bhanuGupta1/esp32-espnow-thingsboard-gateway/evidence/video_02_thingsboard_walkthrough.gif

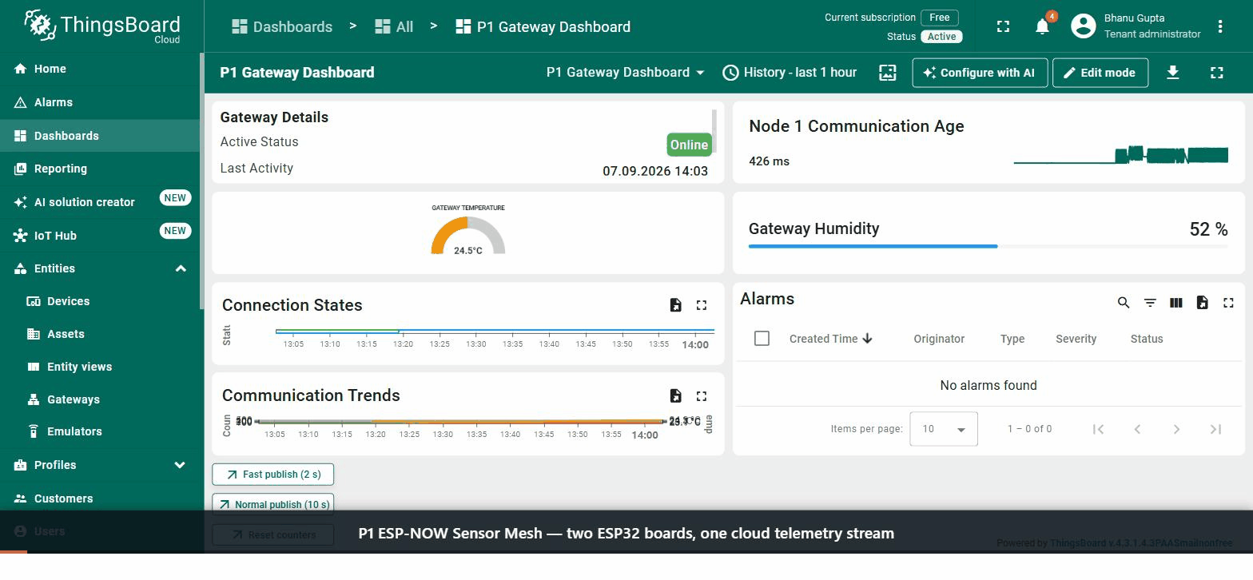
evidence/video_02_thingsboard_walkthrough.gif
