bhanuGupta1/esp32-espnow-thingsboard-gateway/evidence/07_build_sizes.txt

P1 build size evidence
Generated by .claude/verify.local.sh equivalent; arduino-cli arduino-cli  Version: 1.3.1 Commit: 08ff7e2b Date: 2025-08-28T13:51:38Z
Core: esp32:esp32   3.3.3            3.3.8            esp32
FQBN: esp32:esp32:esp32 (ESP32 Dev Module, default partition scheme)

Name                    Installed Available Location Description
Adafruit Unified Sensor 1.1.15    -         user     -
DHT sensor library      1.4.7     -         user     -
FastGPIO                2.2.0     -         user     -
PololuBuzzer            1.2.0     -         user     -
PololuHD44780           2.0.0     -         user     -
PololuOLED              2.0.0     -         user     -
PubSubClient            2.8       -         user     -
Pushbutton              2.0.0     -         user     -
USBPause                2.0.0     -         user     -
Zumo32U4                2.0.1     -         user     -
ZumoAutomation          1.0.3     -         user     -
ZumoShield              2.1.0     -         user     -

=== 01_board1_dht_test ===

Sketch uses 284039 bytes (21%) of program storage space. Maximum is 1310720 bytes.
Global variables use 20816 bytes (6%) of dynamic memory, leaving 306864 bytes for local variables. Maximum is 327680 
bytes.

=== 02_board2_dht_test ===

Sketch uses 284071 bytes (21%) of program storage space. Maximum is 1310720 bytes.
Global variables use 20816 bytes (6%) of dynamic memory, leaving 306864 bytes for local variables. Maximum is 327680 
bytes.

=== 03_board2_gateway_info ===

Sketch uses 885539 bytes (67%) of program storage space. Maximum is 1310720 bytes.
Global variables use 43384 bytes (13%) of dynamic memory, leaving 284296 bytes for local variables. Maximum is 327680 
bytes.

=== 04_board1_espnow_sender ===

Sketch uses 898803 bytes (68%) of program storage space. Maximum is 1310720 bytes.
Global variables use 43504 bytes (13%) of dynamic memory, leaving 284176 bytes for local variables. Maximum is 327680 
bytes.

=== 05_board2_gateway_cloud ===

Sketch uses 1012651 bytes (77%) of program storage space. Maximum is 1310720 bytes.
Global variables use 45624 bytes (13%) of dynamic memory, leaving 282056 bytes for local variables. Maximum is 327680 
bytes.
