bhanuGupta1/esp32-espnow-thingsboard-gateway/(commit log)

2026-08-13 Add ESP-NOW sensor gateway firmware, report and test evidence
    Two-node ESP32 prototype: a remote node reads a DHT11 and unicasts
    readings over ESP-NOW; a gateway node reads its own sensor, receives
    and deduplicates the remote packets, and publishes the merged payload
    to ThingsBoard over MQTT.
    Five staged Arduino sketches, captured serial logs and photographs
    covering all eleven acceptance criteria, and the project report.
    Wi-Fi and cloud credentials are excluded via .gitignore; see
    secrets.example.h for the required constants.
2026-08-13 Embed figures in report, add docx build and demo runsheet
    Figures 1-3 (hardware photographs) and 4-7 (dashboard screenshots) are now
    displayed inline with captions rather than referenced by filename, so the
    portfolio reads as evidence rather than a file listing.
    DEMO_PLAN.md covers the assessed 10-minute demonstration and 5-minute
    question period: a timed running order, the sensor-warming gesture that
    exercises the full sensor-to-cloud path in about fifteen seconds, and
    prepared answers for the design decisions the build invites.
2026-08-13 Verify ESP-NOW sender identity and correct report accuracy claims
    Independent review surfaced that the gateway validated the src_id field
    inside each packet but never checked who actually sent the frame. Because
    it accepts unregistered, unencrypted peers, any nearby ESP-NOW device could
    submit a well-formed packet; one carrying a high sequence number under the
    live boot_id would advance the deduplication baseline and cause every
    genuine packet to be rejected until the node rebooted. The receive callback
    now discards frames whose source MAC is not the configured node address.
    Cross-task counters move to std::atomic. The queue-overflow counter was
    incremented on the Wi-Fi task while loop() re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
    [04_board1_espnow_sender.ino, 05_board2_gateway_cloud.ino]
2026-08-13 Add presentation deck, submission checklist and course documents
    Sixteen-slide deck sized to the assessed ten-minute slot, with speaker
    notes carrying timing and the points worth saying aloud rather than
    putting on a slide.
    Submission checklist records what the two briefs actually require against
    what exists. Part 1 is an individual case study analysis worth 40% and is
    not addressed here; Part 2 is this project. Noting the distinction because
    the Part 2 marking scheme rewards alignment with the case study.
    Also closes the remaining review findings: both sketches now halt rather
    than continue when ESP-NOW setup fails, since carrying on would announce
    that the gateway is listening while it i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
    [04_board1_espnow_sender.ino, 05_board2_gateway_cloud.ino]
2026-08-13 Add Part 1 case study analysis with original diagrams
    Draft of the individual case study assessment covering Project 1, the
    same ESP-NOW sensor network built for Part 2. Six sections to the brief's
    word budgets, seventeen references, and three diagrams drawn from the
    system as implemented rather than from a generic reference architecture:
    system architecture, data flow showing where frames are discarded, and a
    security model marking trust boundaries against residual exposure.
    Passages requiring the author's own experience are left marked rather
    than filled, since the brief asks for prior hands-on work, what the
    author found difficult, and insights from their own background. The
    reference li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
2026-08-13 Encrypt and authenticate the ESP-NOW link
    A second adversarial review rejected source MAC filtering as a trust
    boundary. The objection was correct: 802.11 source addresses are forgeable
    by anyone already able to inject frames, so an attacker could still observe
    the live boot_id, transmit as the node, and advance the deduplication
    baseline until the real sensor was silenced. Filtering on a value the
    attacker controls is not authentication.
    Both boards now install a primary master key and register each other as
    encrypted peers carrying a local master key. A frame is accepted because it
    decrypts under a key the sender must hold rather than because of an address
    the sender chose. The gateway ne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
    [04_board1_espnow_sender.ino, 05_board2_gateway_cloud.ino, secrets.example.h]
2026-08-13 Verify encrypted ESP-NOW on hardware and record a channel roam
    Encryption now runs behind a compile-time flag that must match on both
    boards, and has been confirmed working with the gateway associated to an
    access point while the node is not: 42 packets received with no invalid
    frames and no rejected senders.
    The first hardware test after enabling encryption delivered nothing, which
    looked like encryption failing between an associated and an unassociated
    station. It was not. The gateway had roamed from channel 1 to channel 11
    during the session while the node stayed pinned to the old channel, so no
    frame could have arrived whatever the security settings. Correcting the
    channel restored deli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
    [04_board1_espnow_sender.ino, 05_board2_gateway_cloud.ino]
2026-08-13 Draft case study authenticity sections from the project record
    Sections 8.1 to 8.3 are written from what actually happened: the prior
    solar-powered car project, the three findings that were genuinely new, and
    the misdiagnosis where a channel roam was mistaken for encryption failing.
    All of it is drawn from the session record rather than invented, and is
    marked for the author to correct against their own recollection.
    Sections 8.4 and 8.5 are deliberately left unwritten. They ask for industry
    exposure and personal background, which cannot be reconstructed from what
    the project produced. Both carry scaffolding and candidate angles instead.
    Four references were checked against published recor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
2026-08-13 Add AI use declaration and fill author details
    Declaration drafted to be accurate rather than minimal: it names the
    firmware, both written documents, the two independent code reviews and the
    debugging assistance as AI-assisted, and separates out the physical work,
    the empirical evidence and the project decisions that were not.
    An understated disclosure is a worse position than a complete one, since a
    marker forming a different impression from the work itself would then be
    judging the declaration rather than the assistance.
    Also corrects the case study executive summary, which still described the
    radio link as unencrypted and unauthenticated after that had been fixed and
    verified on hardwar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
2026-08-13 Complete author details across submission documents
    Student name, identifier and cohort filled on both official cover sheets
    and on the title pages of the case study and the AI declaration. Signature
    and date fields are left blank on the cover sheets, since those are signed
    by hand against a declaration of original work.
2026-08-14 Complete case study for submission
    Sections 8.4 and 8.5 written. The industry-parallels section compares the
    design against a documented LoRa agricultural deployment rather than
    claiming direct experience there is none, which is the honest position and
    draws a more useful comparison: same economics of many unconnected sensors
    behind one gateway, but range and inaccessibility make the single-gateway
    risk far more serious in the field than on a bench.
    Sections trimmed to the word budgets set by the brief. The technical
    architecture section was 46 per cent over and is now within range, mostly
    by removing restatement between the executive summary, the security
    subsection and the risk analysis.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
2026-09-03 Add server-to-device RPC and store-and-forward buffering
    The MQTT link was telemetry-only, which makes the device observable but not
    manageable: an operator could see what it reported but could not change how
    it behaved without physical access. The gateway now subscribes to the
    ThingsBoard RPC request topic and implements getStatus, setPublishInterval
    and resetCounters, replying on the matching response topic.
    setPublishInterval range-checks and rejects rather than clamping. Silently
    applying a value the caller did not ask for would leave them believing
    something untrue about the device. The subscription is re-issued on every
    reconnect, since MQTT subscriptions are session state - a device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
    [05_board2_gateway_cloud.ino]
2026-09-03 Keep the document converter with the project
    The Markdown to Word converter was living in a temporary directory and was
    lost when that was cleared, so the documents could not be regenerated from
    source. It now sits in tools/ alongside the material it builds.
2026-09-03 Fix buffer slots being smaller than the payload they hold
    Hardware testing showed the store-and-forward buffer storing nothing. The log
    claimed a payload had been buffered while reporting a queue depth of zero on
    every publish, and buffered_now never moved off zero.
    Slots were 288 bytes, sized against a payload that predated the five RPC and
    buffering telemetry keys. Once those were added the payload reached 326 bytes,
    so every write hit the size guard and returned. The guard returned quietly, and
    the log line printed the queue depth from before the call rather than after, so
    nothing in the output indicated a problem.
    Slot size and payload size now derive from one constant. The size guard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
    [04_board1_espnow_sender.ino, 05_board2_gateway_cloud.ino]
2026-09-06 Add pin-level circuit diagram
    The report carried an architecture block diagram and photographs, but nothing
    that showed which pin connects to which. A reader could not reproduce the build
    from the document alone.
    The generator draws both boards in the wire colours actually used on the bench,
    marks the only wiring difference between them (GPIO4 against GPIO5), and shows
    the ESP-NOW link as the sole path between two otherwise isolated circuits.
2026-09-06 Pin node to channel 1 to match the roamed gateway
    The gateway had settled on channel 1 while the node was still pinned to 6, so
    every transmission went unacknowledged and node telemetry stopped reaching the
    cloud. Wi-Fi and MQTT stayed healthy throughout, which is what makes this
    failure hard to spot.
    Read off the gateway boot banner before a demonstration; the value is a property
    of the access point, not a setting the project controls.
    [04_board1_espnow_sender.ino]
2026-09-06 Record verified bidirectional control and buffer flush
    Both capabilities were implemented but had never been observed working end to
    end: no command had been sent from the dashboard, and the buffer had only ever
    been seen filling, never draining.
    Three RPC command buttons now exist on the dashboard. Pressing them produced the
    request and the applied change in the gateway log, and the new interval and
    handled count came back in the next telemetry publish, so the round trip is
    confirmed from both ends rather than from a dashboard acknowledgement. The same
    capture showed four payloads buffered during an outage and all four flushed with
    none dropped.
    Adds acceptance criteria 12 and 13, section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
2026-09-06 Align case study security claims with the implemented design
    The case study documented ESP-NOW encryption as implemented in its security
    section, then contradicted itself in three places: the specification table
    listed the local protocol as unencrypted, the OWASP assessment claimed missing
    transport encryption on both legs, and the first security recommendation was to
    enable the encryption the system already has.
    Transport encryption is now scoped to the cloud leg, which is where it is
    genuinely absent, and the recommendations start with MQTT over TLS. The
    description of the original design at the top of section 2.4 stays in the past
    tense, since the point it makes about identifiers and aut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
2026-09-06 Bridge the portfolio to the case study and the video evidence
    The heaviest-weighted marking criterion asks that the implementation align with
    the case study, but the portfolio never referred to it. A reader had no way to
    check the two against each other without reading both end to end and building
    the mapping themselves.
    Section 1.1 now states the correspondence point by point, and names the two
    places the work diverged: the sensor substitution, and the RPC and buffering
    capabilities that were added after the analysis was written and that it
    therefore does not describe.
    The brief also asks for demo videos on OneDrive with the links carried in the
    portfolio. There was nowhere to put them, s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
2026-09-06 Rework the video shot list around what the system can now do
    The shot list predated bidirectional control, so it captured only the upward
    path. Pressing a dashboard button and watching the device change behaviour is
    the strongest single thing this project can show, and it was missing.
    Adds that shot, a note on demonstrating the buffer by pulling the network
    rather than the board, and a pre-flight check for the roamed channel.
    Also specifies -NoReset on the serial monitor. Attaching without it reboots the
    board, which reprints the boot banner and puts the eduroam identity on screen
    in a recording intended for upload.
2026-09-07 Name both authors and state the contribution split
    The portfolio is a group submission but carried one author and a placeholder,
    so nothing in it recorded who the second author was or how the work divided.
    Section 11.1 was already written in the first person plural, so it stands as a
    joint reflection and needs no second version.
2026-09-07 Draft the generative AI disclosure
    The section held example placeholders rather than a statement, so there was
    nothing to submit against a requirement the brief makes explicitly.
    The draft records AI involvement as substantial, because it was, and sets
    against it the work the authors did themselves: all hardware assembly, wiring
    and physical testing, all evidence capture, and the operation of the boards
    during every test that produced a result in this portfolio.
    Wording still needs checking against the course's own Responsible Use of AI
    guidelines before it is signed.
2026-09-07 Capture both boards on one clock
    Every previous log reads a single serial port, so the node's "link-layer ack
    received" and the gateway's "ESP-NOW rx" were two separate observations that
    had to be trusted to describe the same packet. Polling both ports from one
    process closes that gap: the same sequence number appears at both ends one
    millisecond apart, which also measures the radio round trip.
    The link was down when the capture started. The gateway had settled on channel
    6 while the node was still pinned to 1 from earlier today, so the first attempt
    recorded the failure rather than the success - the node reporting no ack while
    the gateway published its own readings and declared the node of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
    [04_board1_espnow_sender.ino]
2026-09-07 Record the cloud half of the demo and fix the mesh dashboard
    The second dashboard held both line charts in a narrow column, so the plots sat
    below the fold and it rendered as two empty boxes. Both are now full width and
    stacked, and the traces they were built to compare are visible: the gateway's
    own sensor against the remote node arriving by radio.
    Adds a screen recording of the dashboard responding to a command - live
    telemetry, the button press, and the device reporting the new interval and
    handled count back in its own telemetry. It covers the cloud portion of the
    demonstration only; the hardware shots still have to be filmed.
2026-09-07 Add a captioned walkthrough of the cloud tier
    The earlier capture showed the RPC round trip and nothing else, which left the
    dashboards themselves undocumented in motion.
    This one runs the whole cloud story with subtitles burned into the frames: the
    gateway online, node communication age counting in milliseconds, the command
    going down and the device reporting the new interval back, the node keys that
    originate on a board with no network connection, and both sensors drawn on one
    chart.
    It still covers the cloud tier only. The boards do not appear in it, so the
    demonstration video is not replaced by it, and the report says so rather than
    letting a reader assume otherwise.
2026-09-07 Assemble the demonstration video and script its narration
    The phone footage of the boards and the two screen captures existed as three
    separate files a marker would have to open in turn and mentally stitch
    together. They are now one 1280x720 cut with title and section cards, subtitles
    burned into the frames, and the portrait phone clip seated on a blurred fill
    rather than pillarboxed.
    Two seconds of the walkthrough show a page mid-load. That is what navigating
    actually looked like, so it stays.
    The narration is scripted against the assembled timings with word counts per
    segment, and the script says plainly which three shots are still missing: the
    sensor warmed by hand, and Board 1 disconne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
2026-09-07 Cut the bench footage into the demonstration video
    Two clips filmed at the bench are now in the timeline: the dashboard running
    beside the hardware, and Board 1 having its power pulled. The video runs 1:49.
    The caption on the disconnection says what the frame shows and no more. The
    consequence - node1_online going false after twenty seconds - is not in the
    footage, so it is attributed to section 8.5 rather than implied. The narration
    script carries the same warning against claiming it on camera.
    That missing shot is now the first item on the list of what still needs
    filming, because without it the sequence pulls a cable and asks the viewer to
    take the result on trust.
2026-09-07 Remove the last placeholders and correct two false claims
    The video is 7 MB, under Moodle's 40 MB limit, so it is submitted with the
    portfolio rather than hosted. The two "paste OneDrive share link" placeholders
    are gone along with the need for them.
    The AI declaration carried two statements that were not true. It said the case
    study has seventeen references when it has eighteen, and that the unchecked
    ones are marked in that document as requiring verification, which they are not.
    Both are corrected, because a declaration that misdescribes the work is worse
    than the disclosure it was meant to make.
    It also named one author while Part 2 is a joint submission, so Roshan Aryal is
    named with t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
2026-09-07 Add narration to the demonstration video and declare it
    The narration runs 130 s against a 109 s cut. The extra 21 s is absorbed by the
    static cards rather than by stretching footage, because stretching would drift
    the burned-in captions away from what is on screen. A pause in the narration
    falls within a second of the recap-card boundary, which suggests the blocks are
    tracking, but the synchronisation has not been checked by ear.
    The voice is synthesised, not either author's. That is now stated in the
    generative AI declaration alongside the subtitles and the agent-driven screen
    captures, and the portfolio's video section points a reader to it. A synthetic
    voice presented as a student's own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
2026-09-07 Re-time the cut so the picture holds as long as the narration
    The first attempt put all the spare time into the static cards, which left the
    footage running at its original speed while the narration covering it had
    grown. The picture kept arriving before the voice was finished with it.
    The stretch is now uniform across every segment, and the narration is 6 percent
    quicker, which reduces the slowdown the footage needs from 19 percent to 13 and
    keeps it looking natural. Pitch is preserved.
2026-09-07 Add the second author's cover sheet and declaration
    Both cover sheets carried one name, so the second author had nothing to sign.
    His cover sheet now has his own name and ID, and his declaration is scoped to
    Part 2 only, since the case study was an individual submission.
    His copy opens by saying it was prepared from the shared project record rather
    than from his own account, and that he should change anything that does not
    match his recollection. A declaration about someone's conduct is not something
    a collaborator can write for them.
2026-09-10 Add a block diagram and take the co-author's deck
    The portfolio had a wiring diagram and an ASCII topology but nothing that
    showed the system as tiers, which is the view that makes the gateway's role
    obvious: it is the only device holding both the Wi-Fi credentials and the
    ESP-NOW keys, and that is the entire mechanism by which the node reaches the
    cloud without joining it.
    The deck is now Roshan's version, which fills in the author line and date and
    corrects the acceptance criteria count. Slide 4 carries the block diagram in
    place of the ASCII art, and a wiring slide follows it.
    Also repinned the node to channel 1. The gateway had roamed again over the
    weekend and the link was down when t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
    [04_board1_espnow_sender.ino, make_block.py]
2026-09-10 Write speaker notes into every slide
    The deck said what the project is but carried nothing about how to present it,
    so the presenter was left reconstructing the argument live.
    Each slide now has notes with a time budget, the words to say, and the backup
    detail a question would need. They are longest where the explaining actually
    happens: the two diagrams, the security story, and the three minutes of live
    hardware where most of the marks are.
    The notes also carry the things worth saying before being asked - the one-hop
    limitation, the sensor substitution, and the unencrypted cloud leg.
